modelec/pcb_puissance/pcb_puissance.step

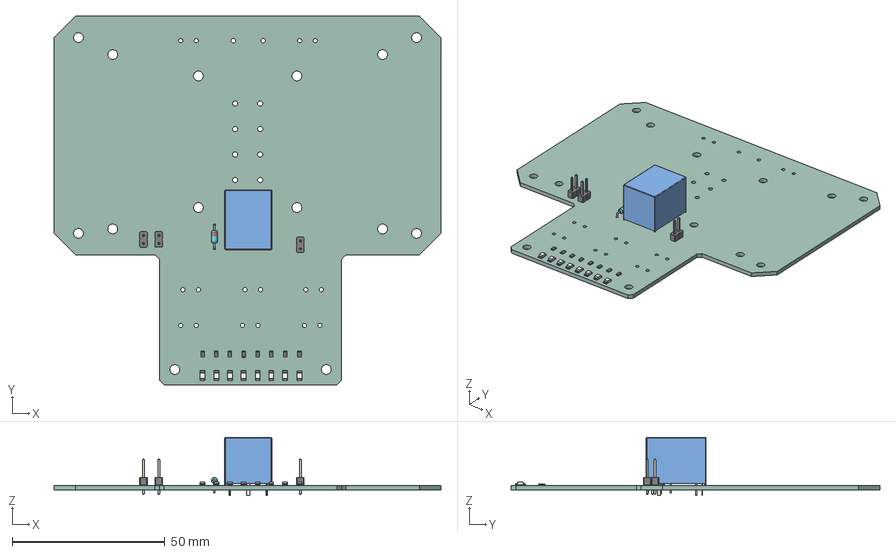
[picture p9: CAD file, 2024-03-18]
pcb_puissance.step
126.5 x 120.5 x 19.0 mm
pcb_puissance PCB
