modelec/pcb_puissance/pcb_puissance.kicad_pcb

## KiCad design pcb_puissance.kicad_pcb (2024-03-18)

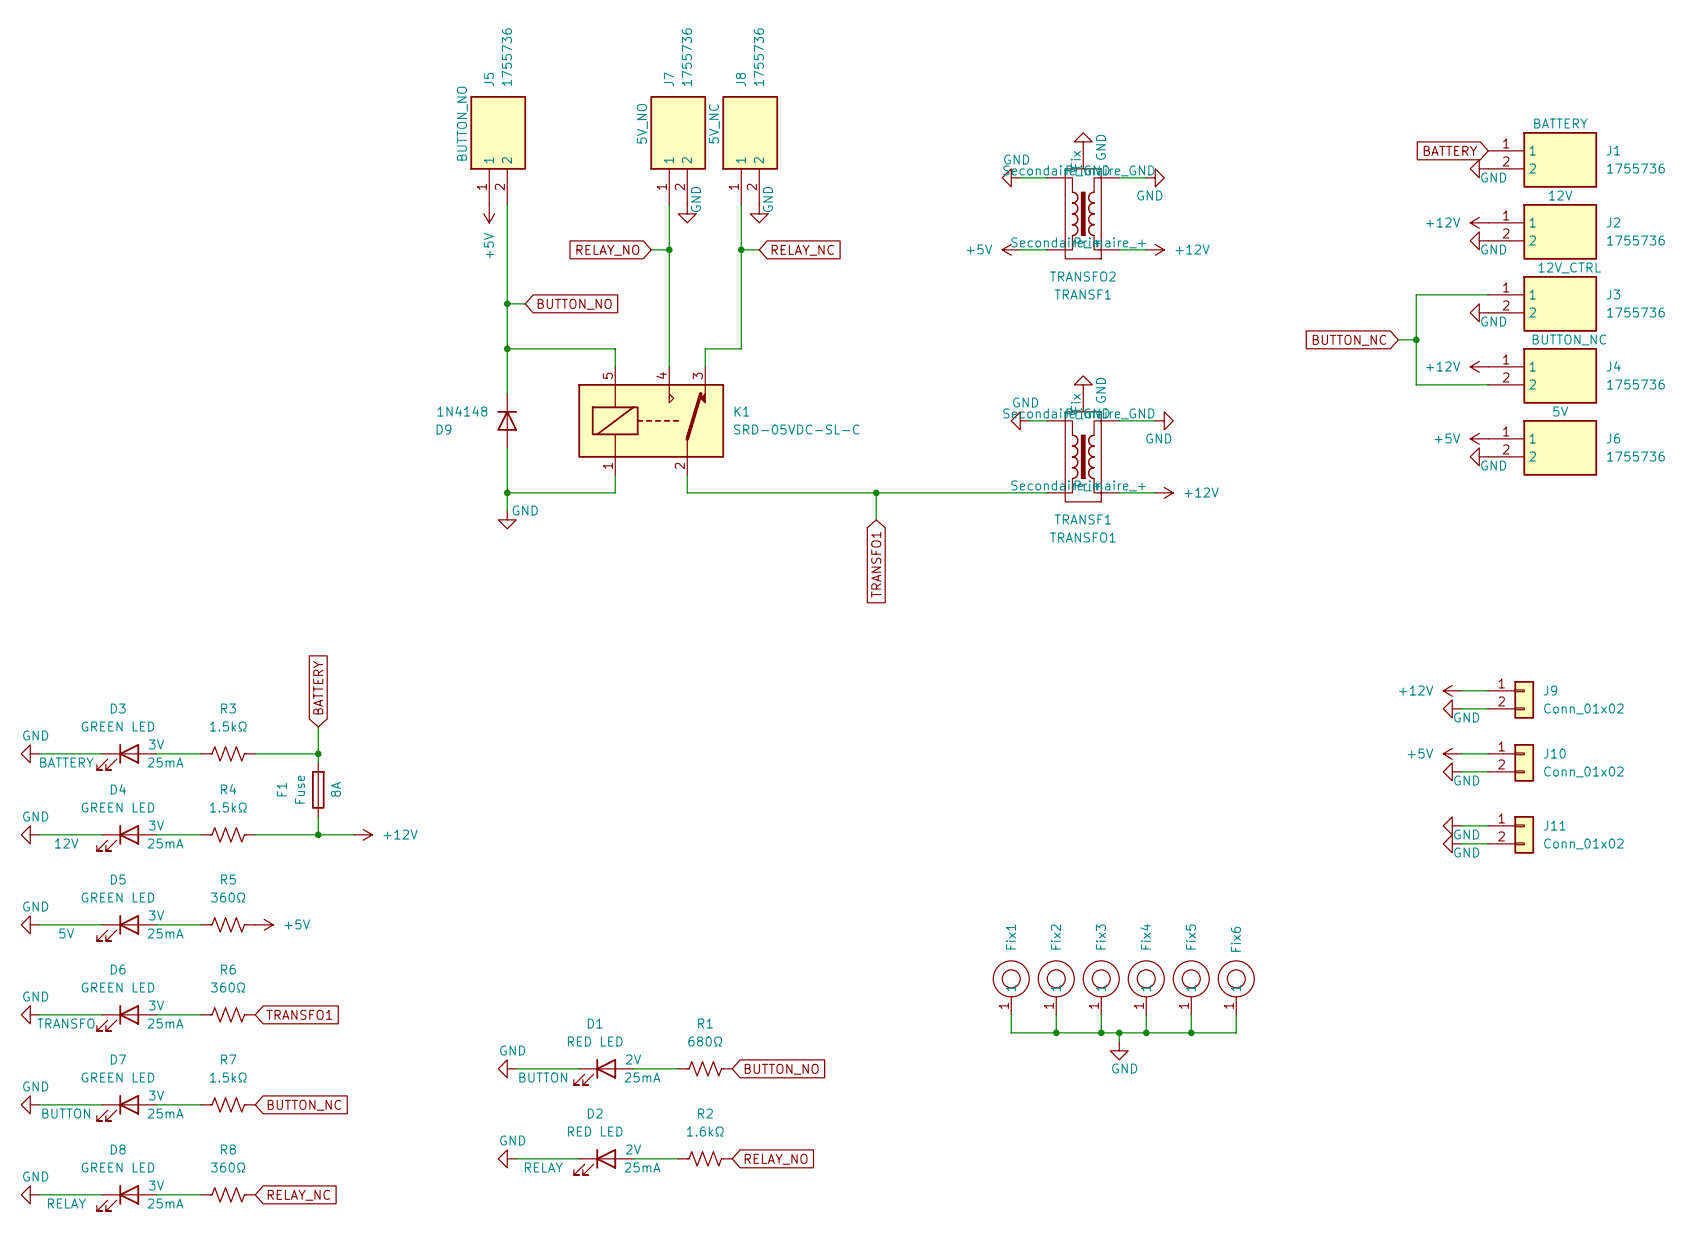
[picture p10: schematic pcb_puissance.kicad_sch, Carte de puissance]

Parts:
D1, D2: RED LED; LED_1206_3216Metric
D3, D4, D5, D6, D7, D8: GREEN LED; LED_1206_3216Metric
D9: 1N4148; D_DO-35_SOD27_P7.62mm_Horizontal
F1: Fuse; porte fusible E44
Fix1, Fix2, Fix3, Fix4, Fix5, Fix6: FIX3.2P7.5
J1, J2, J3, J4, J5, J6, J7, J8: 1755736; Manufacturer_Part_Number 1755736; Mouser Part Number 651-1755736
J9, J10, J11: Conn_01x02; PinHeader_1x02_P2.54mm_Vertical
K1: SRD-05VDC-SL-C
R1: 680Ω; R_0805_2012Metric
R2: 1.6kΩ; R_0805_2012Metric
R3, R4, R7: 1.5kΩ; R_0805_2012Metric
R5, R6, R8: 360Ω; R_0805_2012Metric
TRANSFO1, TRANSFO2: TRANSF1; transfo

Connections:
+5V: J5.1, J6.1, J10.1, R5.2, TRANSFO2.4 (Secondaire_+)
+12V: F1.1, J2.1, J4.1, J9.1, R4.2, TRANSFO1.1 (Primaire_+), TRANSFO2.1 (Primaire_+)
BATTERY: F1.2, J1.1, R3.2
BUTTON_NC: J3.1, J4.2, R7.2
BUTTON_NO: D9.1 (K), J5.2, K1.5, R1.2
GND: D1.1 (K), D2.1 (K), D3.1 (K), D4.1 (K), D5.1 (K), D6.1 (K), D7.1 (K), D8.1 (K), D9.2 (A), Fix1.1, Fix2.1, Fix3.1, Fix4.1, Fix5.1, Fix6.1, J1.2, J2.2, J3.2, J6.2, J7.2, J8.2, J9.2, J10.2, J11.1, J11.2, K1.1, TRANSFO1.2 (Primaire_GND), TRANSFO1.3 (Secondaire_GND), TRANSFO1.5 (Fix), TRANSFO2.2 (Primaire_GND), TRANSFO2.3 (Secondaire_GND), TRANSFO2.5 (Fix)
unnamed: D1.2 (A), R1.1
unnamed: D2.2 (A), R2.1
unnamed: D3.2 (A), R3.1
unnamed: D4.2 (A), R4.1
unnamed: D5.2 (A), R5.1
unnamed: D6.2 (A), R6.1
unnamed: D7.2 (A), R7.1
unnamed: D8.2 (A), R8.1
RELAY_NC: J8.1, K1.3, R8.2
RELAY_NO: J7.1, K1.4, R2.2
TRANSFO1: K1.2, R6.2, TRANSFO1.4 (Secondaire_+)

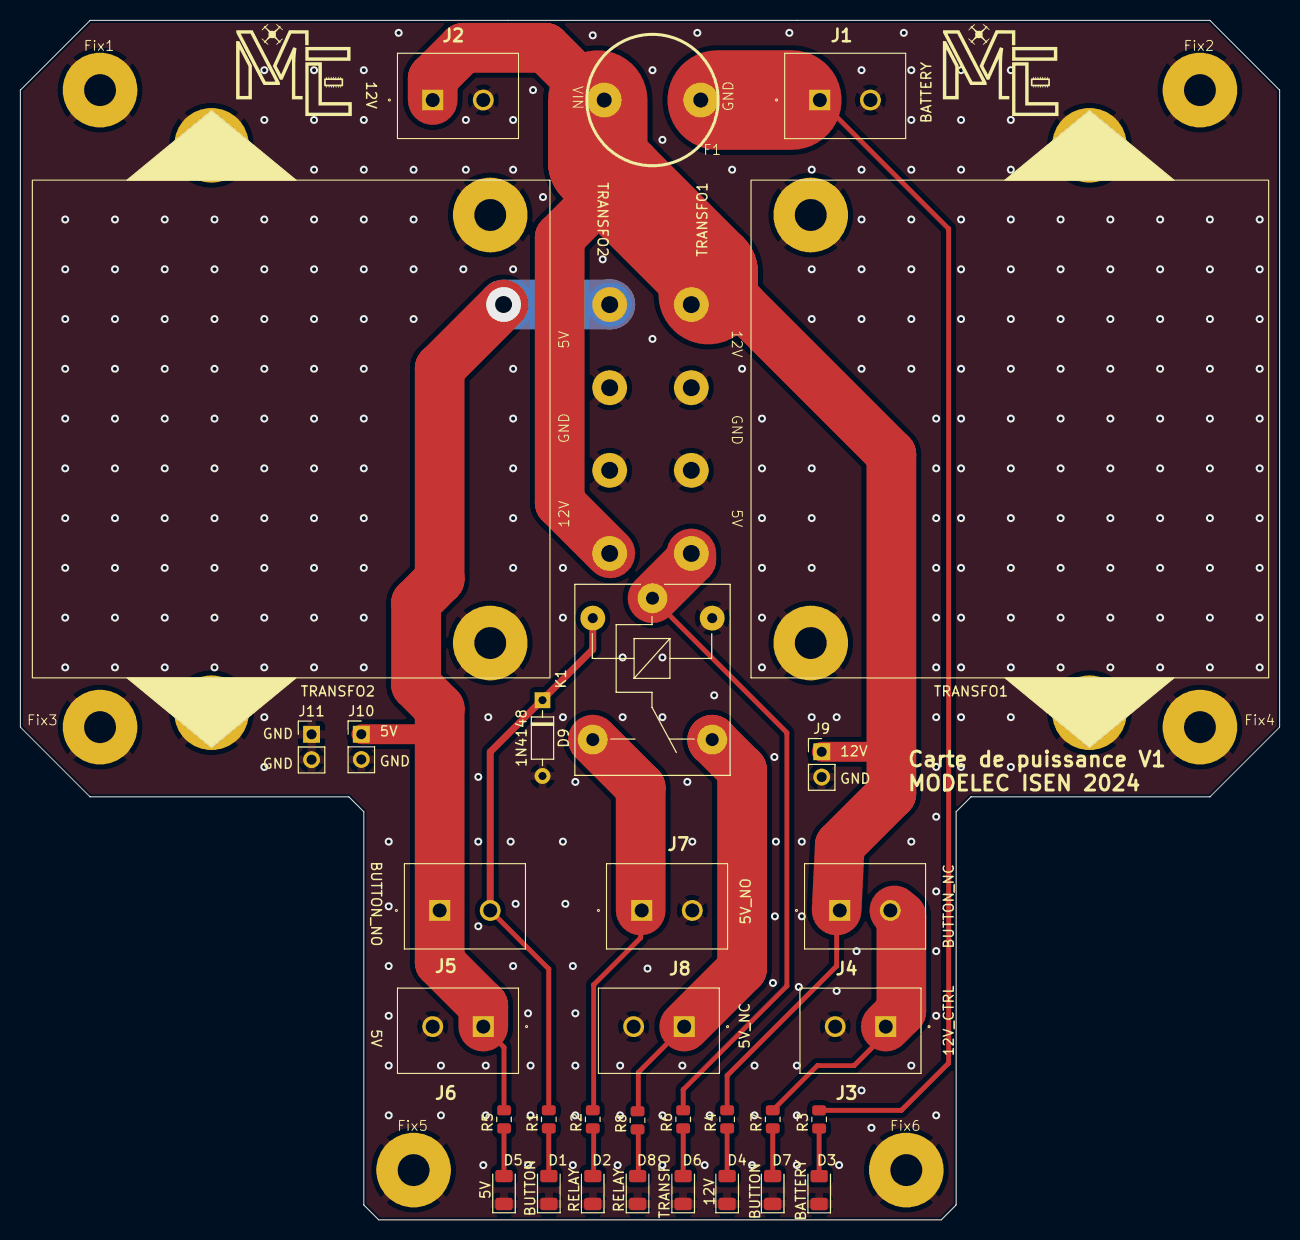
[picture p11: board pcb_puissance.kicad_pcb from above]

Board: 2 copper layers, 126.5 x 120.5 mm, 38 parts (0 on the bottom side), 17 nets.
