modelec/pcb_puissance/(commit log)

2023-12-20 Add KiCAD files
    [pcb_puissance.kicad_pcb, pcb_puissance.kicad_sch]
2023-12-20 changements connecteur CI + placement empreintes et routage PCB
    [pcb_puissance.kicad_pcb, pcb_puissance.kicad_sch]
2023-12-20 Fin routage + contour/plan de masse/entretoises propres.
    [pcb_puissance.kicad_pcb, pcb_puissance.kicad_sch]
2023-12-20 Agrandissement piste batterie -> 10mm
    [pcb_puissance.kicad_pcb]
2023-12-21 Deplacement connecteurs, petites pistes 0.5mm, ajout connecteurs Dupond, plan de masse Front, pastilles pour les fixations
    [pcb_puissance-B_Cu.gbr, pcb_puissance-B_Mask.gbr, pcb_puissance-B_Paste.gbr, pcb_puissance-B_Silkscreen.gbr, pcb_puissance-Edge_Cuts.gbr, pcb_puissance-F_Cu.gbr, pcb_puissance-F_Mask.gbr, pcb_puissance-F_Paste.gbr]
2023-12-22 Pastilles oubliées + ajout vias + plus d'espace pour les connecteurs
    [pcb_puissance.kicad_pcb]
2023-12-22 Génération nouveaux fichiers fabrication
    [pcb_puissance-B_Cu.gbr, pcb_puissance-B_Mask.gbr, pcb_puissance-B_Paste.gbr, pcb_puissance-B_Silkscreen.gbr, pcb_puissance-Edge_Cuts.gbr, pcb_puissance-F_Cu.gbr, pcb_puissance-F_Mask.gbr, pcb_puissance-F_Paste.gbr]
2023-12-22 Vias dans les pastilles + textes cachés par les connecteurs
    [pcb_puissance-B_Cu.gbr, pcb_puissance-B_Mask.gbr, pcb_puissance-B_Paste.gbr, pcb_puissance-B_Silkscreen.gbr, pcb_puissance-Edge_Cuts.gbr, pcb_puissance-F_Cu.gbr, pcb_puissance-F_Mask.gbr, pcb_puissance-F_Paste.gbr]
2023-12-24 DRC, nettoyage pistes cachées, ajout logos
    [pcb_puissance-B_Cu.gbr, pcb_puissance-B_Mask.gbr, pcb_puissance-B_Paste.gbr, pcb_puissance-B_Silkscreen.gbr, pcb_puissance-Edge_Cuts.gbr, pcb_puissance-F_Cu.gbr, pcb_puissance-F_Mask.gbr, pcb_puissance-F_Paste.gbr]
2023-12-24 Ajout noms transfos +visibles
    [pcb_puissance-B_Cu.gbr, pcb_puissance-B_Mask.gbr, pcb_puissance-B_Paste.gbr, pcb_puissance-B_Silkscreen.gbr, pcb_puissance-Edge_Cuts.gbr, pcb_puissance-F_Cu.gbr, pcb_puissance-F_Mask.gbr, pcb_puissance-F_Paste.gbr]
2023-12-26 Rectification empreinte relai
    [pcb_puissance-B_Cu.gbr, pcb_puissance-B_Mask.gbr, pcb_puissance-B_Paste.gbr, pcb_puissance-B_Silkscreen.gbr, pcb_puissance-Edge_Cuts.gbr, pcb_puissance-F_Cu.gbr, pcb_puissance-F_Mask.gbr, pcb_puissance-F_Paste.gbr]
2024-03-18 Correctifs version 1.2
    [pcb_puissance-B_Cu.gbr, pcb_puissance-B_Mask.gbr, pcb_puissance-B_Paste.gbr, pcb_puissance-B_Silkscreen.gbr, pcb_puissance-Edge_Cuts.gbr, pcb_puissance-F_Cu.gbr, pcb_puissance-F_Mask.gbr, pcb_puissance-F_Paste.gbr]
